hey-its-brian/bigtrak/(commit log)

2026-08-17 Milestone 1: drive board motion test
    Two-board Big Trak rebuild firmware. This is the drive half only:
    TB6612FNG motor control over LEDC PWM, plus a hardcoded on-blocks
    motion test to verify wiring before anything else gets built on top.
2026-10-02 Milestone 2: gamepad driving on the drive board
    Move drive/ to ESP-IDF with Arduino as a component so Bluepad32 (BTstack)
    can run on the classic ESP32. Components are fetched at pinned versions by
    drive/tools/fetch_components.sh; platform 55.03.312 with Arduino core 3.3.12.
    - Bluepad32 pad driving: arcade mix, deadzone, speed cap with R1 turbo,
    accel/decel ramping, disconnect failsafe, one pad at a time
    - 3S battery monitor: BATT reports, low warning, latched cutoff
    - Non-blocking photon cannon flash
    - UART2 link to the CYD with a strict protocol parser
    - USB console (status, test, forget) plus protocol lines for bench testing
    - Pin map and thresholds updated for carrier PCB rev 1
    - Nativ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
    [battery.cpp, battery.h, battery_logic.h, cannon.cpp, cannon.h, config.h, cyd_link.cpp, cyd_link.h]
2026-10-02 Milestone 3: CYD touchscreen keypad
    LovyanGFX UI for the ESP32-3248S035C (hand-configured ST7796 + GT911):
    original-style keypad, program list with executing-step highlight,
    battery and pad status, beeps on every key. Program entry logic and the
    protocol layer are pure C++ with native unit tests. Protocol lines go to
    USB serial until milestone 4 switches the link to Serial1 (TX 22, RX 35).
2026-10-02 Milestones 5 and 6: program engine with encoder closed-loop moves
    - Program queue (16 steps) with ACK/ERR per line, GO/CLS/STOP, and RPT
    expanded recursively into the run, capped at 256 steps
    - Non-blocking runner: STEP n (program row, 1-based) and DONE to the CYD,
    brake-settle between steps, HOLD in tenths, FIRE via the cannon
    - Closed-loop FWD/BACK/LEFT/RIGHT on PCNT quadrature encoders (glitch
    filter, overflow accumulation), cruise/slow approach, straight-line trim,
    stall abort; timed fallback when ENCODERS_ENABLED is false
    - Gamepad input aborts a running program (ERR gamepad override); a pad
    disconnect no longer stops a program that isn't using the pad
    - Calibration in NVS via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
    [config.h, encoders.cpp, encoders.h, main.cpp, program_logic.h, program_runner.cpp, program_runner.h, settings.cpp]
2026-10-03 Add parametric OpenSCAD parts: drive pod, drive wheels, CYD mount
    - drive_pod: replaces the original gearbox at its 4 screw points; two
    JGA25-370 motors back to back, direct drive to the middle wheels
    - drive_wheel: printed middle wheel with #232 O-ring grooves, D-bore hub,
    set screw and captive nut
    - cyd_bezel / cyd_back: keypad-recess bezel with display window and
    standoffs, back cover with connector openings, one screw set for both
    - fit_tests: shaft bore, motor face, CYD hole pattern, O-ring groove
    - params.scad separates drawing values from MEASURE placeholders
    - SPEC: middle wheels are the driven pair; drive pod replaces gearbox
    [cyd_back.scad, cyd_bezel.scad, drive_pod.scad, drive_wheel.scad, fit_tests.scad, params.scad]
